bareboat-necessities/bbn_alarms_A/(threads)

Thread 1 (2025-03-06):

Create tcp server using esp32-at

mgrouch, 2025-03-06:
If you're using the **M5Stack PoE Ethernet Unit** with the **ESP-AT firmware** that supports Ethernet, you can create a TCP server using AT commands. The ESP-AT firmware provides a set of commands to configure the ESP32 as a TCP server over Ethernet.

Below is an example of how to set up a TCP server on the M5Stack PoE Ethernet Unit using ESP-AT commands.

---

### Prerequisites:
1. Ensure your M5Stack PoE Ethernet Unit is flashed with the **ESP-AT firmware** that supports Ethernet.
2. Connect the M5Stack PoE Ethernet Unit to your M5Stack device.
3. Use a UART connection (e.g., Serial2 on the M5Stack) to send AT commands to the Ethernet unit.

---

### Example: TCP Server with M5Stack PoE Ethernet Unit

#### Hardware Setup:
- Connect the M5Stack PoE Ethernet Unit to your M5Stack device.
- Use the UART pins (TX, RX) to communicate with the Ethernet unit.

---

#### Code: TCP Server with ESP-AT Commands

```cpp
#include <M5Stack.h>

// Define the UART pins for communication with the Ethernet unit
#define ETH_RX 16  // Connect to TX of the Ethernet unit
#define ETH_TX 17  // Connect to RX of the Ethernet unit

void setup() {
  // Initialize M5Stack
  M5.begin();
  Serial.begin(115200);  // Serial for debugging
  Serial2.begin(115200, SERIAL_8N1, ETH_RX, ETH_TX);  // UART for Ethernet unit

  // Wait for the Ethernet unit to initialize
  delay(1000);

  // Send AT command to check if the Ethernet unit is ready
  sendATCommand("AT");
  delay(1000);

  // Initialize Ethernet
  sendATCommand("AT+ETHERNET=1");
  delay(1000);

  // Set up the TCP server on port 333
  sendATCommand("AT+CIPSERVER=1,333");
  delay(1000);

  Serial.println("TCP Server is ready on port 333");
}

void loop() {
  // Check for incoming data from the Ethernet unit
  if (Serial2.available()) {
    String response = Serial2.readString();
    Serial.println(response);

    // Check if a new client has connected
    if (response.startsWith("+IPD")) {
      // Extract the connection ID and data
      int connectionId = response.charAt(5) - '0';  // Get the connection ID
      String data = response.substring(7);  // Get the data

      Serial.print("Received data from connection ID: ");
      Serial.println(connectionId);
      Serial.print("Data: ");
      Serial.println(data);

      // Send a response back to the client
      String responseMessage = "Hello from M5Stack TCP Server!";
      sendATCommand("AT+CIPSEND=" + String(connectionId) + "," + String(responseMessage.length()));
      delay(100);
      sendATCommand(responseMessage);
    }
  }
}

void sendATCommand(const String& command) {
  Serial.println("Sending: " + command);
  Serial2.println(command);  // Send the command to the Ethernet unit
  delay(500);  // Wait for the Ethernet unit to respond

  // Read the response from the Ethernet unit
  while (Serial2.available()) {
    String response = Serial2.readString();
    Serial.println("Response: " + response);
  }
}
```

---

### Explanation of the Code:
1. **AT Commands**:
   - `AT`: Checks if the Ethernet unit is ready.
   - `AT+ETHERNET=1`: Initializes the Ethernet connection.
   - `AT+CIPSERVER=1,333`: Sets up the TCP server on port 333.
   - `AT+CIPSEND=<connectionId>,<length>`: Sends data to a specific client.

2. **Handling Incoming Data**:
   - The `+IPD` response indicates incoming data from a client. The connection ID and data are extracted from this response.

3. **Sending Data**:
   - Use `AT+CIPSEND` to send data back to the client.

---

### Key AT Commands for Ethernet:
- `AT+ETHERNET=1`: Enable Ethernet mode.
- `AT+CIPSTATUS`: Check the network status.
- `AT+CIPSERVER=1,<port>`: Start a TCP server on the specified port.
- `AT+CIPSEND=<connectionId>,<length>`: Send data to a client.

---

### Notes:
- Replace the `ETH_RX` and `ETH_TX` pins with the actual pins you're using for UART communication.
- Ensure the baud rate of `Serial2` matches the baud rate of the Ethernet unit (default is 115200).
- The `delay()` functions are used to give the Ethernet unit time to process commands. Adjust as necessary.

---

This example demonstrates how to create a TCP server on the M5Stack PoE Ethernet Unit using ESP-AT commands. If you encounter any issues, refer to the **ESP-AT Command Set** documentation for Ethernet-specific commands and troubleshooting.

Closed 2025-03-08.
