bareboat-necessities/bbn_alarms_A/sleep_n_wakeup.h

#ifndef sleep_n_wakeup_h
#define sleep_n_wakeup_h

#define uS_TO_S_FACTOR 1000000

#define SLEEP_DURATION (15 * 60 * uS_TO_S_FACTOR)

void cat_nap(unsigned long sleep_uS = SLEEP_DURATION) {
  esp_sleep_enable_timer_wakeup(sleep_uS);
  esp_deep_sleep_start();
}

#endif
